notsergiu2314/Embedded_Bop_It/bop_it_report/figures/fig-wiring.pdf

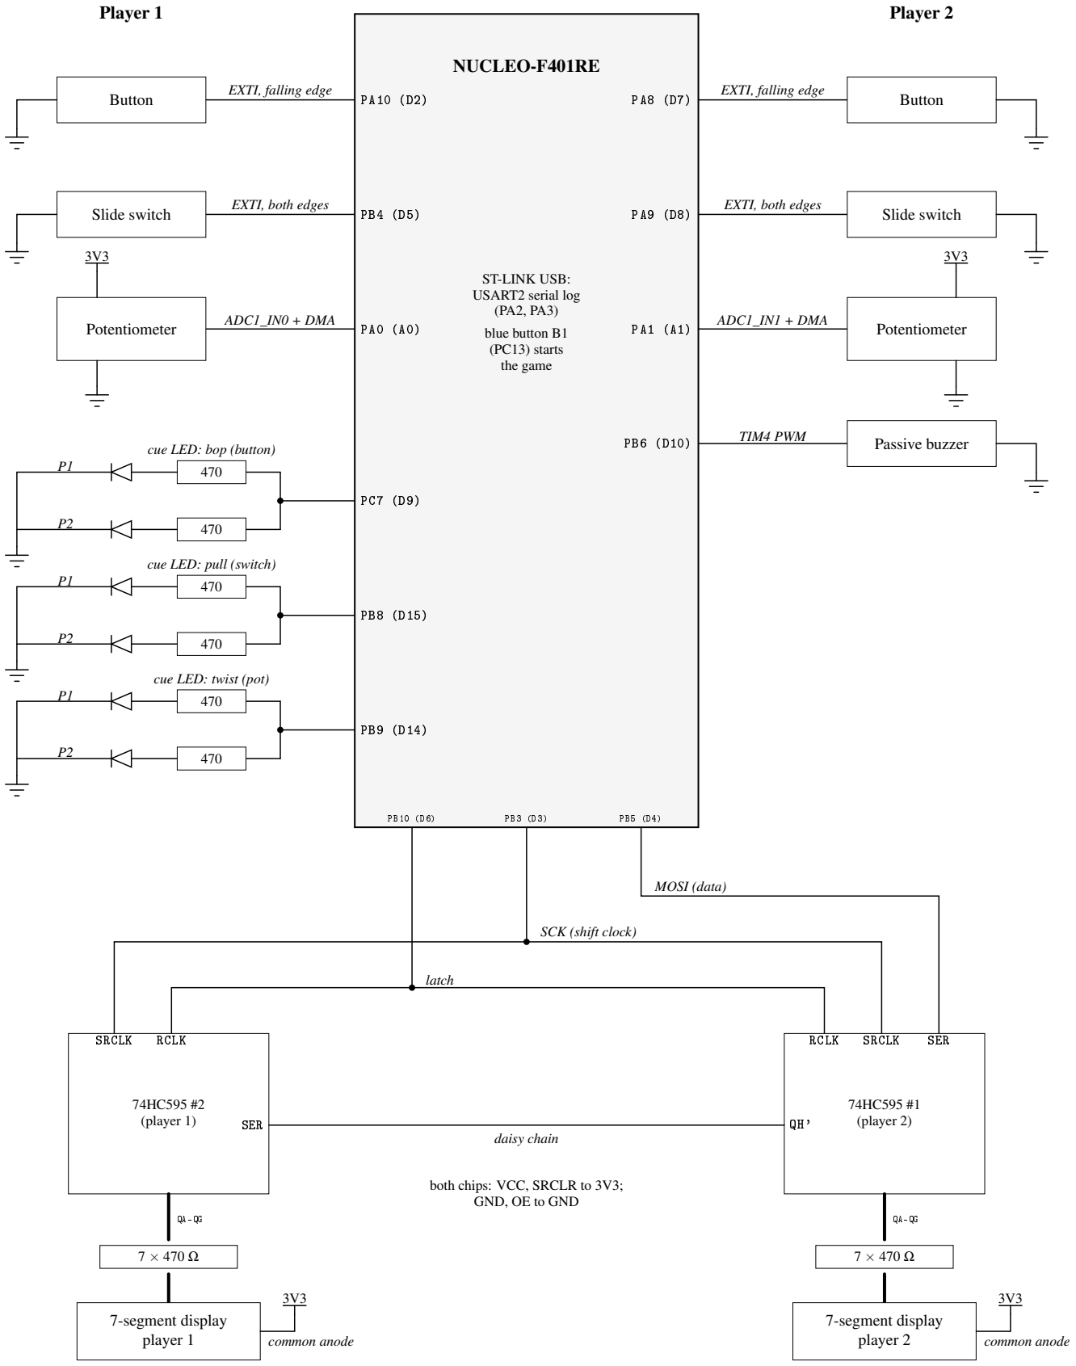
[picture p1: figure]
NUCLEO-F401RE; ST-LINK USB: USART2 serial log (PA2, PA3); blue button B1 (PC13) starts the game; Player 1; Button; EXTI, falling edge; Slide switch; EXTI, both edges; Potentiometer; ADC1_IN0 + DMA; cue LED: bop (button); cue LED: pull (switch); cue LED: twist (pot); Player 2; Button EXTI, falling edge; Slide switch EXTI, both edges; ADC1_IN1 + DMA; Passive buzzer TIM4 PWM; MOSI (data); SCK (shift clock); latch; 74HC595 #1 (player 2); RCLK; SRCLK; SER; 74HC595 #2 (player 1); daisy chain; both chips: VCC, SRCLR to 3V3; GND, OE to GND; 7-segment display player 2; common anode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
