notsergiu2314/Embedded_Bop_It/Core/Inc/main.h

#define B1_Pin GPIO_PIN_13
#define B1_GPIO_Port GPIOC
#define B1_EXTI_IRQn EXTI15_10_IRQn
#define LED_POT_P2_Pin GPIO_PIN_1
#define LED_POT_P2_GPIO_Port GPIOC
#define USART_TX_Pin GPIO_PIN_2
#define USART_TX_GPIO_Port GPIOA
#define USART_RX_Pin GPIO_PIN_3
#define USART_RX_GPIO_Port GPIOA
#define LED_BTN_P2_Pin GPIO_PIN_4
#define LED_BTN_P2_GPIO_Port GPIOA
#define LD2_Pin GPIO_PIN_5
#define LD2_GPIO_Port GPIOA
#define LED_SW_P2_Pin GPIO_PIN_0
#define LED_SW_P2_GPIO_Port GPIOB
#define LATCH_595_Pin GPIO_PIN_10
#define LATCH_595_GPIO_Port GPIOB
#define LED_BTN_P1_Pin GPIO_PIN_7
#define LED_BTN_P1_GPIO_Port GPIOC
#define BTN_P2_Pin GPIO_PIN_8
#define BTN_P2_GPIO_Port GPIOA
#define BTN_P2_EXTI_IRQn EXTI9_5_IRQn
#define SW_P2_Pin GPIO_PIN_9
#define SW_P2_GPIO_Port GPIOA
#define SW_P2_EXTI_IRQn EXTI9_5_IRQn
#define BTN_P1_Pin GPIO_PIN_10
#define BTN_P1_GPIO_Port GPIOA
#define BTN_P1_EXTI_IRQn EXTI15_10_IRQn
#define TMS_Pin GPIO_PIN_13
#define TMS_GPIO_Port GPIOA
#define TCK_Pin GPIO_PIN_14
#define TCK_GPIO_Port GPIOA
#define SW_P1_Pin GPIO_PIN_4
#define SW_P1_GPIO_Port GPIOB
#define SW_P1_EXTI_IRQn EXTI4_IRQn
#define LED_SW_P1_Pin GPIO_PIN_8
#define LED_SW_P1_GPIO_Port GPIOB
#define LED_POT_P1_Pin GPIO_PIN_9
#define LED_POT_P1_GPIO_Port GPIOB
