notsergiu2314/Embedded_Bop_It/(commit log)

2026-10-18 Initial CubeMX project, board layer and pinout
    NUCLEO-F401RE project generated with STM32CubeMX (FreeRTOS CMSIS-RTOS V2),
    App/board.[ch] pin tables and drivers, and docs/PINOUT.md.
2026-10-18 Fix timer prescalers, add README
2026-10-20 Exclude App/ from the build (for now)
    main.c is the product; App/ stays in the repository as a reference only.
    Its source folder is removed from the CubeIDE project so board.c and the
    other App files are no longer compiled (they also defined a second
    HAL_GPIO_EXTI_Callback). The App/Inc include path is kept.
2026-10-23 add game initialization code, fix compilation errors, add config variables, add blue button input
2026-10-30 wiring figure added
